darts/gulp/cad/gulp.FCStd

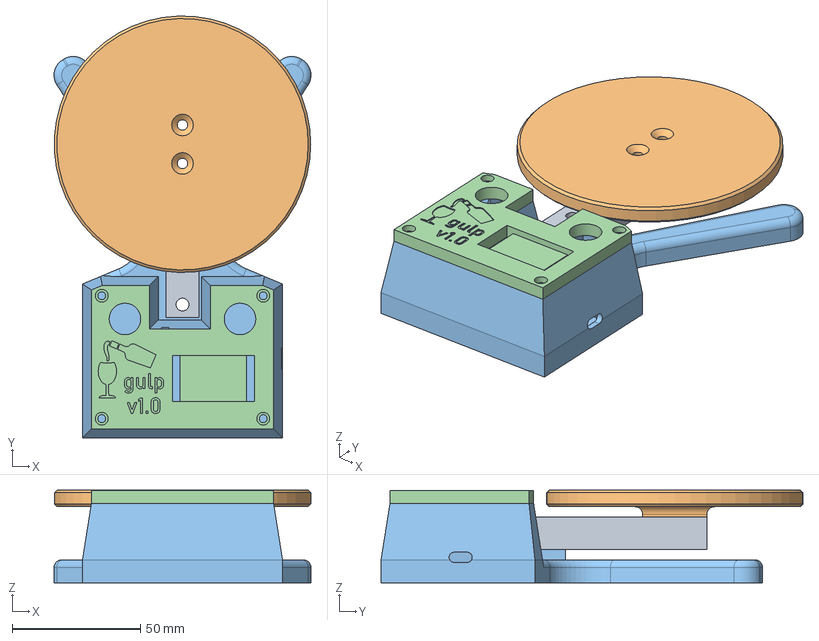
[picture p2: CAD file, 2026-04-03]
cad/gulp.FCStd
100.2 x 164.5 x 36.2 mm
Load cell
Top001
Base001
Lid001
