darts/gulp/cad/stl/lid.3mf

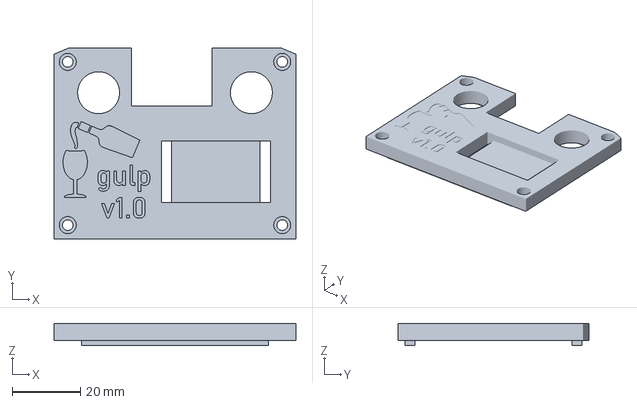
[picture p3: CAD file, 2026-04-03]
cad/stl/lid.3mf
71.0 x 56.0 x 6.60 mm
