darts/gulp/cad/stl/base.3mf

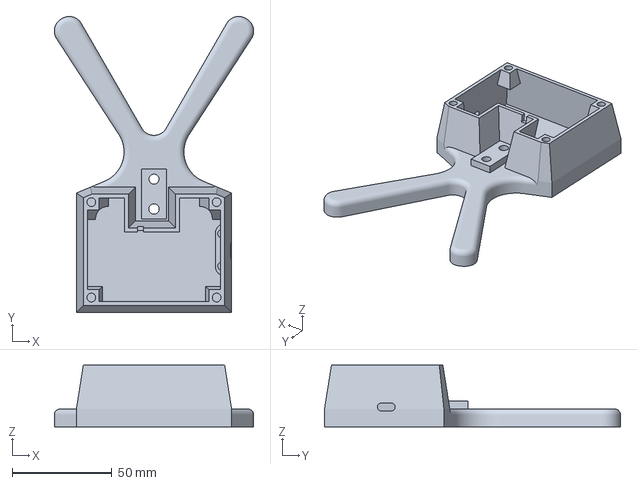
[picture p4: CAD file, 2026-04-03]
cad/stl/base.3mf
100.2 x 148.7 x 31.0 mm
