darts/gulp/cad/stl/top.3mf

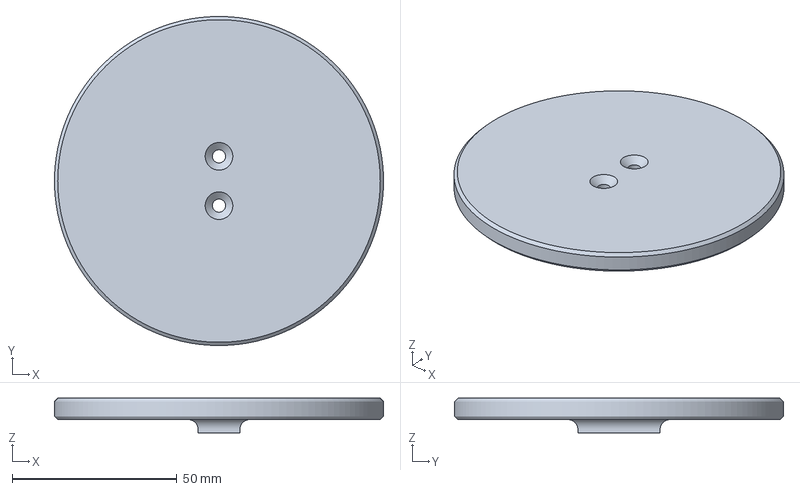
[picture p5: CAD file, 2026-04-03]
cad/stl/top.3mf
100.0 x 100.0 x 10.5 mm
