darts/gulp/(list of files, cad)

Other CAD files:
cad/stl/gulp.3mf
