darts/gulp/(commit log)

2026-03-19 Initial CAD
    [gulp.FCStd]
2026-04-03 Add 3mf files
    [base.3mf, gulp.3mf, gulp.FCStd, lid.3mf, top.3mf]
2026-04-19 Clarify absence of images in assembly instructions
    Updated README to clarify lack of images in assembly instructions.
